isadora-fernanda/autocorrelacao-vhdl-fpga/nios/main.c

#include <stdio.h>
#include "stdbool.h"
# include "io.h"
#include "altera_avalon_uart.h"
#include "system.h"
#include "sys/alt_stdio.h"
#include "alt_types.h"
#include "sys/alt_irq.h"
#define CTRL_REG   512*4 // LEMBRANDO QUE ADRESS MODE AQUI É +4
#define STATUS_REG 513*4


float REAL[128];
float IMAG[128];

union RecordType    // Declaração de union type
{
    float  f; // Lembrando que é passado para 32 bits!
    unsigned long d;
}R1, I1, R2, I2, R, I;

// Aqui, enquanto STATUS_REG não mudar os status, a FPGA ainda está realizando
// a multiplicação
void start_mult(void){
	IOWR_32DIRECT(0x00040000, CTRL_REG, 1); // Send start command
	unsigned long temp = IORD_32DIRECT(0x00040000, STATUS_REG); // Read status
	while(temp!=1){
		printf("STATUS = 0x%x\r\n", temp);
		temp = IORD_32DIRECT(0x00040000, STATUS_REG);
	}
	printf("STATUS = 0x%x\r\n", temp);
	printf("\r\n");
}
void ack(){
	IOWR_32DIRECT(0x00040000, CTRL_REG, 0); // Stop command!
}
int main()
{
	unsigned long i, j;
	j = 0;
	R1.f=-117.52977;
	I1.f=-92.430313;
	REAL[0]=R1.f;
	IMAG[0]=I1.f;
	R1.f=159.33696;
	I1.f=17.780727;
	REAL[1]=R1.f;
	IMAG[1]=I1.f;
	R1.f=-3.5624268;
	I1.f=173.31172;
	REAL[2]=R1.f;
	IMAG[2]=I1.f;
	R1.f=-118.231;
	I1.f=-78.470955;
	REAL[3]=R1.f;
	IMAG[3]=I1.f;
	R1.f=114.29395;
	I1.f=-157.50946;
	REAL[4]=R1.f;
	IMAG[4]=I1.f;
	R1.f=108.92054;
	I1.f=35.891842;
	REAL[5]=R1.f;
	IMAG[5]=I1.f;
	R1.f=-126.58447;
	I1.f=88.65139;
	REAL[6]=R1.f;
	IMAG[6]=I1.f;
	R1.f=-53.039734;
	I1.f=-90.260071;
	REAL[7]=R1.f;
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
	R1.f=108.07452;
	I1.f=-50.782951;
	REAL[115]=R1.f;
	IMAG[115]=I1.f;
	R1.f=798.16943;
	I1.f=-38.517273;
	REAL[116]=R1.f;
	IMAG[116]=I1.f;
	R1.f=-54.734509;
	I1.f=-85.531181;
	REAL[117]=R1.f;
	IMAG[117]=I1.f;
	R1.f=8.1394367;
	I1.f=-10.670733;
	REAL[118]=R1.f;
	IMAG[118]=I1.f;
	R1.f=-38.588566;
	I1.f=109.8129;
	REAL[119]=R1.f;
	IMAG[119]=I1.f;
	R1.f=10.258254;
	I1.f=-9.2361841;
	REAL[120]=R1.f;
	IMAG[120]=I1.f;
	R1.f=55.282444;
	I1.f=40.828434;
	REAL[121]=R1.f;
	IMAG[121]=I1.f;
	R1.f=-274.35751;
	I1.f=24.594076;
	REAL[122]=R1.f;
	IMAG[122]=I1.f;
	R1.f=45.970078;
	I1.f=-82.983009;
	REAL[123]=R1.f;
	IMAG[123]=I1.f;
	R1.f=78.52552;
	I1.f=19.516382;
	REAL[124]=R1.f;
	IMAG[124]=I1.f;
	R1.f=-117.92378;
	I1.f=5.7055359;
	REAL[125]=R1.f;
	IMAG[125]=I1.f;
	R1.f=-53.370628;
	I1.f=-41.125969;
	REAL[126]=R1.f;
	IMAG[126]=I1.f;
	R1.f=0.74434173;
	I1.f=43.303764;
	REAL[127]=R1.f;
	IMAG[127]=I1.f;

	// São salvos em REAL e IMAG
	for(i=0; i<128; i++)
	{
		R1.f = REAL[i];
        I1.f = IMAG[i];
		IOWR_32DIRECT(0x00040000, j  , R1.d);
		j+=4;
		IOWR_32DIRECT(0x00040000, j, I1.d);
		j+=4;
	}
	j = 0;


	// Calcula autocorrelação
	start_mult();

	// Lê resultado
	j = 0x400;
	R1.d = IORD_32DIRECT(0x00040000, j);
	printf("Valor real = %f\r\n", R1.f);
	j = 0x404;
	I1.d = IORD_32DIRECT(0x00040000, j);

	printf("Valor imaginário = %f\r\n", I1.f);
	ack();
	while(1); // Loop

  return 0;
}
