isadora-fernanda/autocorrelacao-vhdl-fpga/(commit log)

2026-10-14 Adiciona TCC: autocorrelação em VHDL para medição de velocidade (2022)
    Trabalho de Conclusão de Curso em Engenharia Eletrônica (UTFPR, 2022). Implementação em VHDL do método de autocorrelação na FPGA MAX 10 (DE10-Lite), com ponto flutuante IEEE 754 e Nios II. Inclui código VHDL, programa do Nios II, projeto do Quartus, simulação no GHDL, script do MATLAB e o texto do TCC.
2026-10-15 Corrige comentários do código
    [System.vhd, fp_add.vhd]
2026-10-15 Deixa o diagrama de arquitetura em preto e branco
